premkumar22siva/C263C_Control_of_Robotic_System/Pictures & Video/20250611_194209.jpg

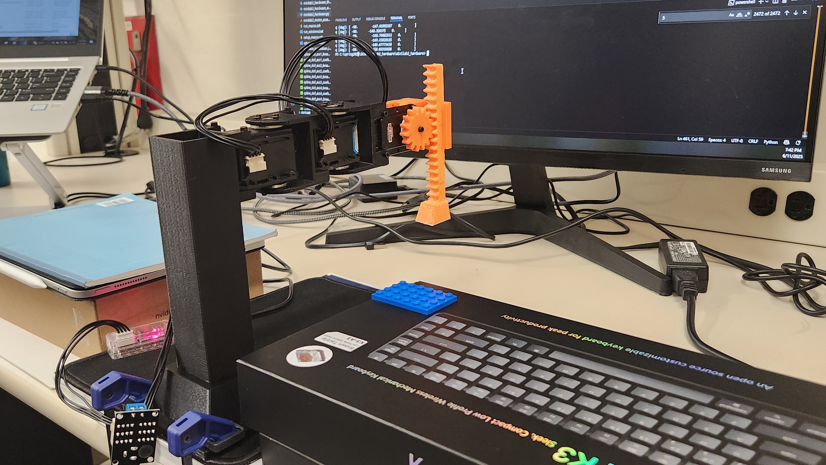
Pictures & Video/20250611_194209.jpg
