premkumar22siva/C263C_Control_of_Robotic_System/CAD/Final Assembly.SLDASM

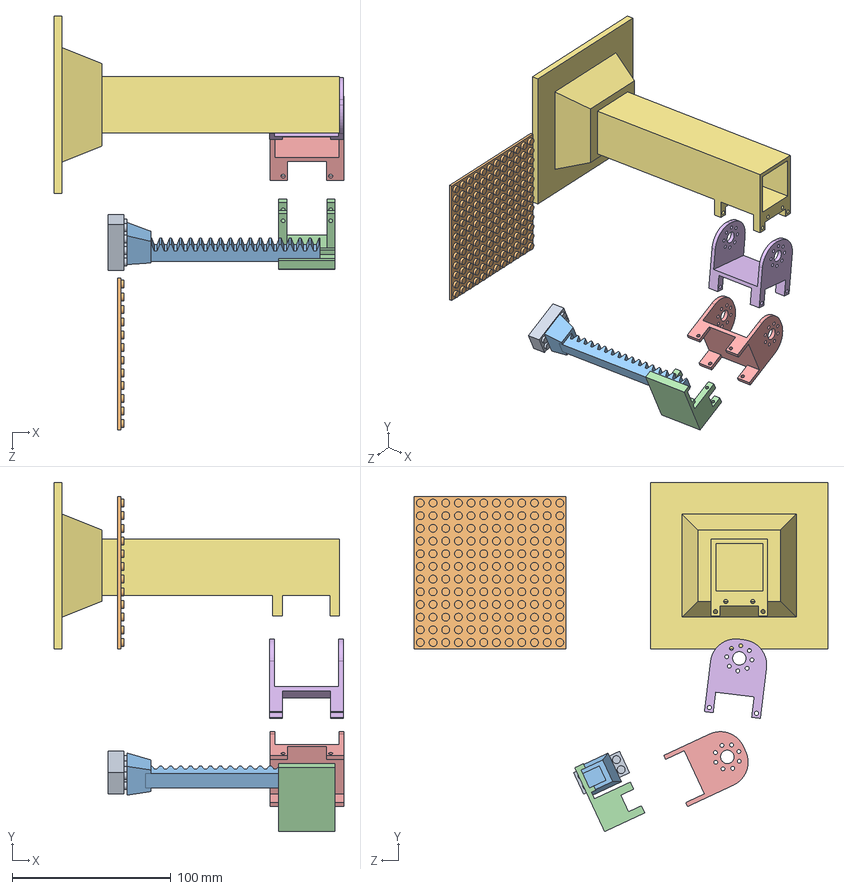
[picture p27: CAD file, 2025-07-06]
CAD/Final Assembly.SLDASM
182.6 x 220.3 x 261.1 mm
D1
Link1
Link2
Lat Link 3_hole2.5_len21.5_Working
press rack-9.5 pitch height
Lego bed
Lego
