premkumar22siva/C263C_Control_of_Robotic_System/CAD/Lego bed.SLDPRT

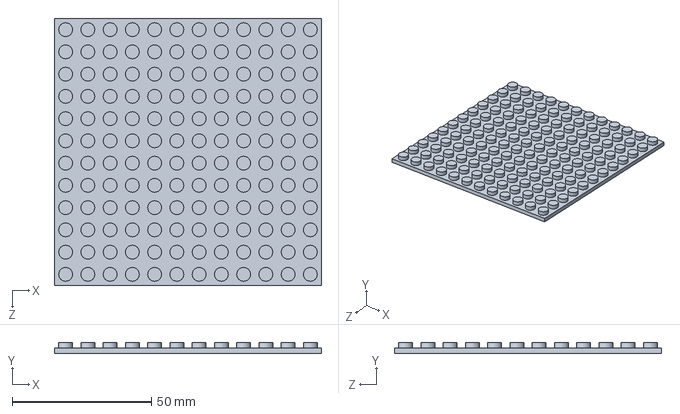
[picture p28: CAD file, 2025-07-06]
CAD/Lego bed.SLDPRT
96.0 x 4.00 x 96.0 mm
