premkumar22siva/C263C_Control_of_Robotic_System/CAD/Link2.SLDPRT

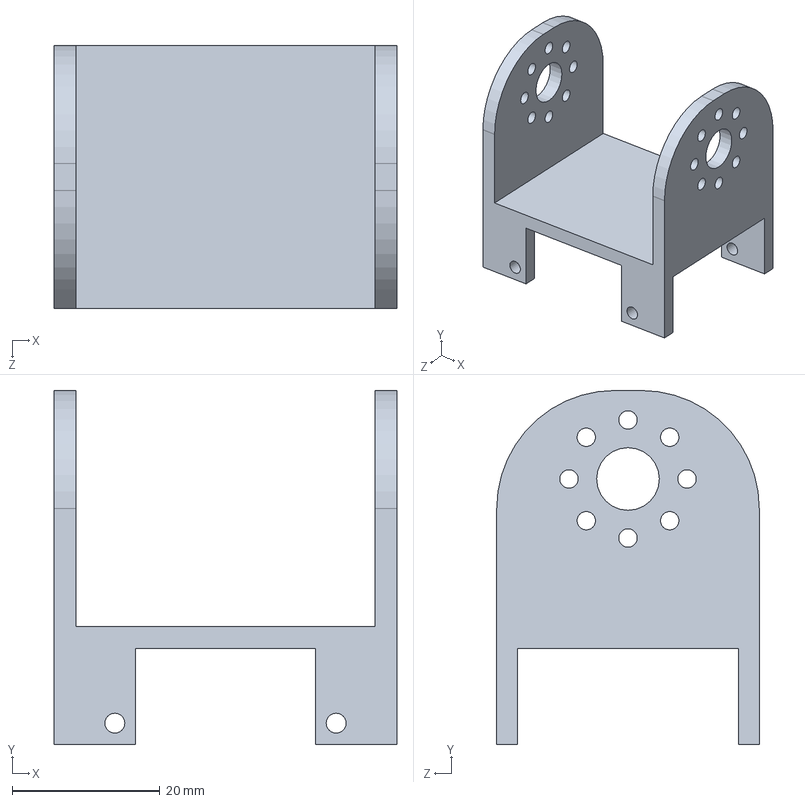
[picture p29: CAD file, 2025-07-06]
CAD/Link2.SLDPRT
46.5 x 48.0 x 35.6 mm
