premkumar22siva/C263C_Control_of_Robotic_System/CAD/D1.SLDPRT

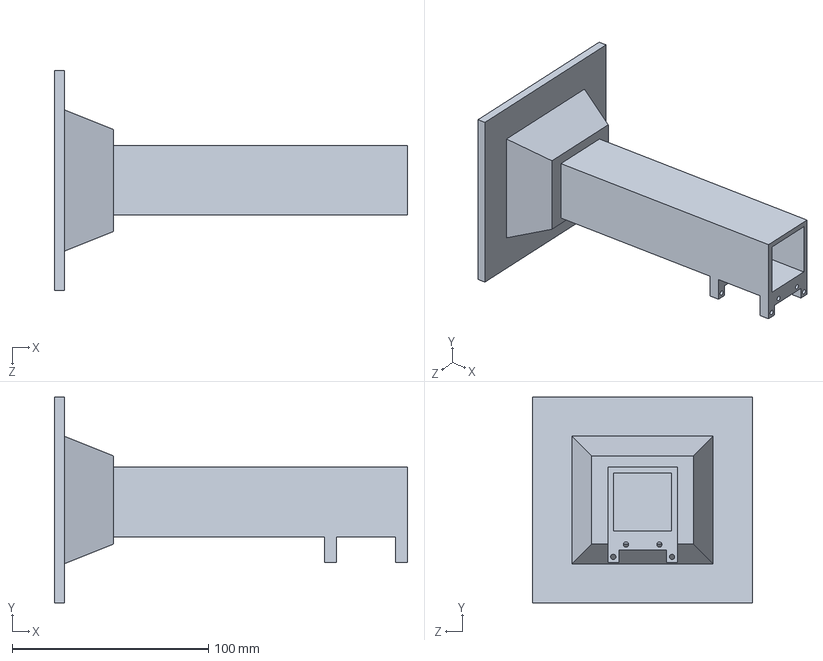
[picture p30: CAD file, 2025-07-06]
CAD/D1.SLDPRT
180.0 x 105.0 x 112.1 mm
