premkumar22siva/C263C_Control_of_Robotic_System/CAD/New_gear_prism_PK.SLDPRT

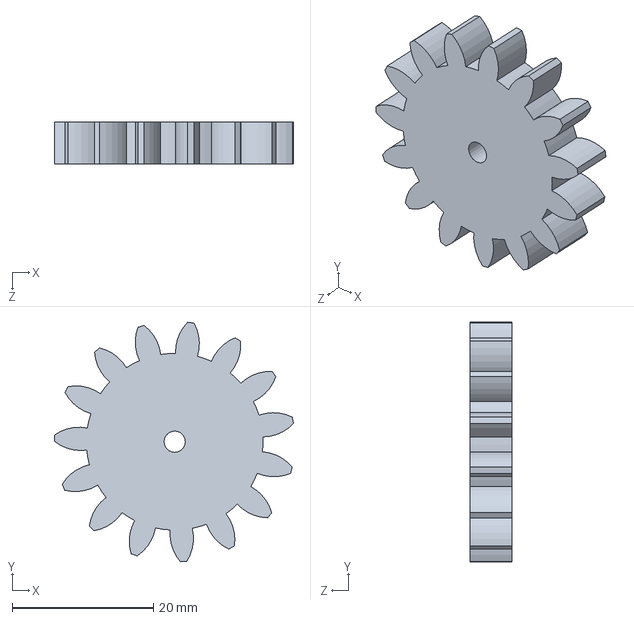
[picture p31: CAD file, 2025-07-06]
CAD/New_gear_prism_PK.SLDPRT
33.8 x 33.9 x 6.00 mm
