premkumar22siva/C263C_Control_of_Robotic_System/CAD/Lego.SLDPRT

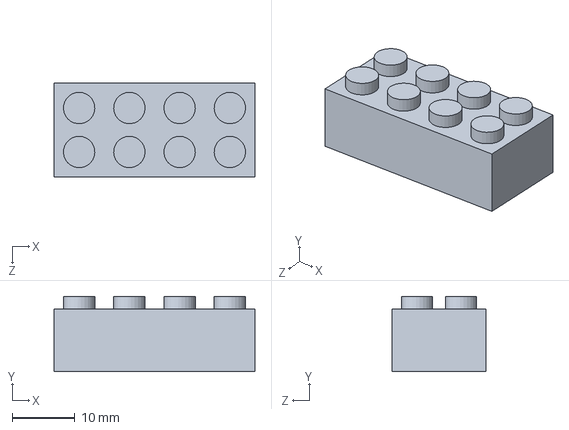
[picture p32: CAD file, 2025-07-06]
CAD/Lego.SLDPRT
32.0 x 12.0 x 15.0 mm
