premkumar22siva/C263C_Control_of_Robotic_System/CAD/Lat Link 3_hole2.5_len21.5_Working.SLDPRT

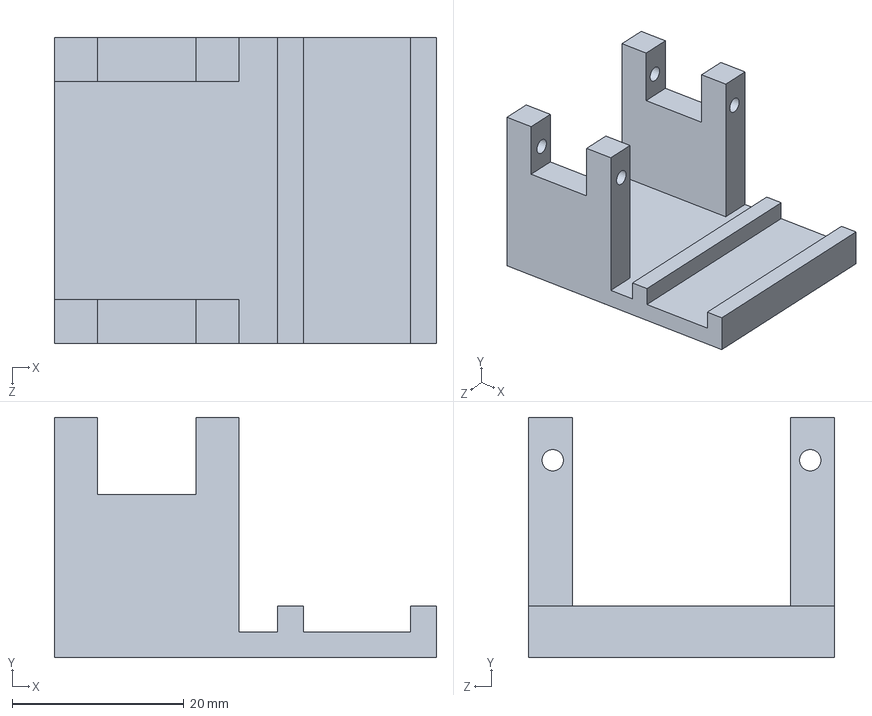
[picture p33: CAD file, 2025-07-06]
CAD/Lat Link 3_hole2.5_len21.5_Working.SLDPRT
44.5 x 28.0 x 35.6 mm
