premkumar22siva/C263C_Control_of_Robotic_System/CAD/press rack-9.5 pitch height.SLDPRT

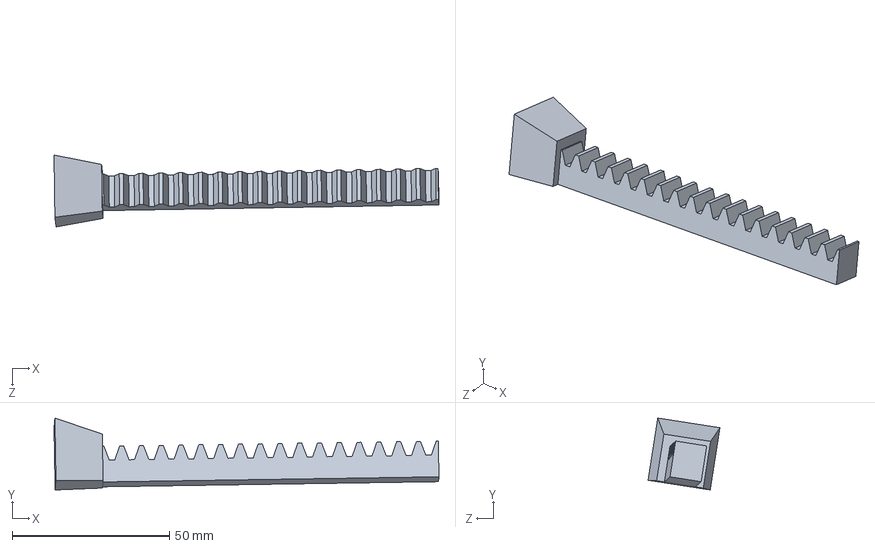
[picture p34: CAD file, 2025-07-06]
CAD/press rack-9.5 pitch height.SLDPRT
122.2 x 22.8 x 22.8 mm
