premkumar22siva/C263C_Control_of_Robotic_System/CAD/Link1.SLDPRT

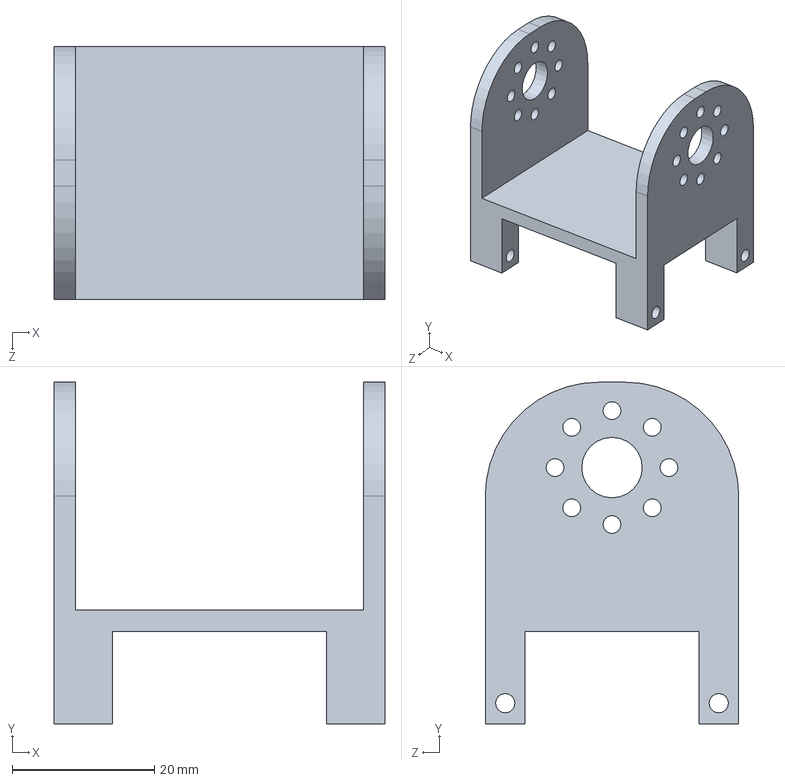
[picture p35: CAD file, 2025-07-06]
CAD/Link1.SLDPRT
46.5 x 48.0 x 35.6 mm
