premkumar22siva/C263C_Control_of_Robotic_System/(commit log)

2025-07-06 CAD Files
    [D1.SLDPRT, Final Assembly.SLDASM, Lat Link 3_hole2.5_len21.5_Working.SLDPRT, Lego bed.SLDPRT, Lego.SLDPRT, Link1.SLDPRT, Link2.SLDPRT, New_gear_prism_PK.SLDPRT]
2025-07-06 Generated trajectory via points
    [spline_dof_acc1_breaks.csv, spline_dof_acc1_coefs.csv, spline_dof_acc2_breaks.csv, spline_dof_acc2_coefs.csv, spline_dof_acc3_breaks.csv, spline_dof_acc3_coefs.csv, spline_dof_acc4_breaks.csv, spline_dof_acc4_coefs.csv]
